mmi-sc/JISD5601Pulse/README.md

# JISD5601Pulse
JIS D 5601 Speed Pulse Generator
