mmi-sc/JISD5601Pulse/KiCad/CarSpeedPulser.pdf

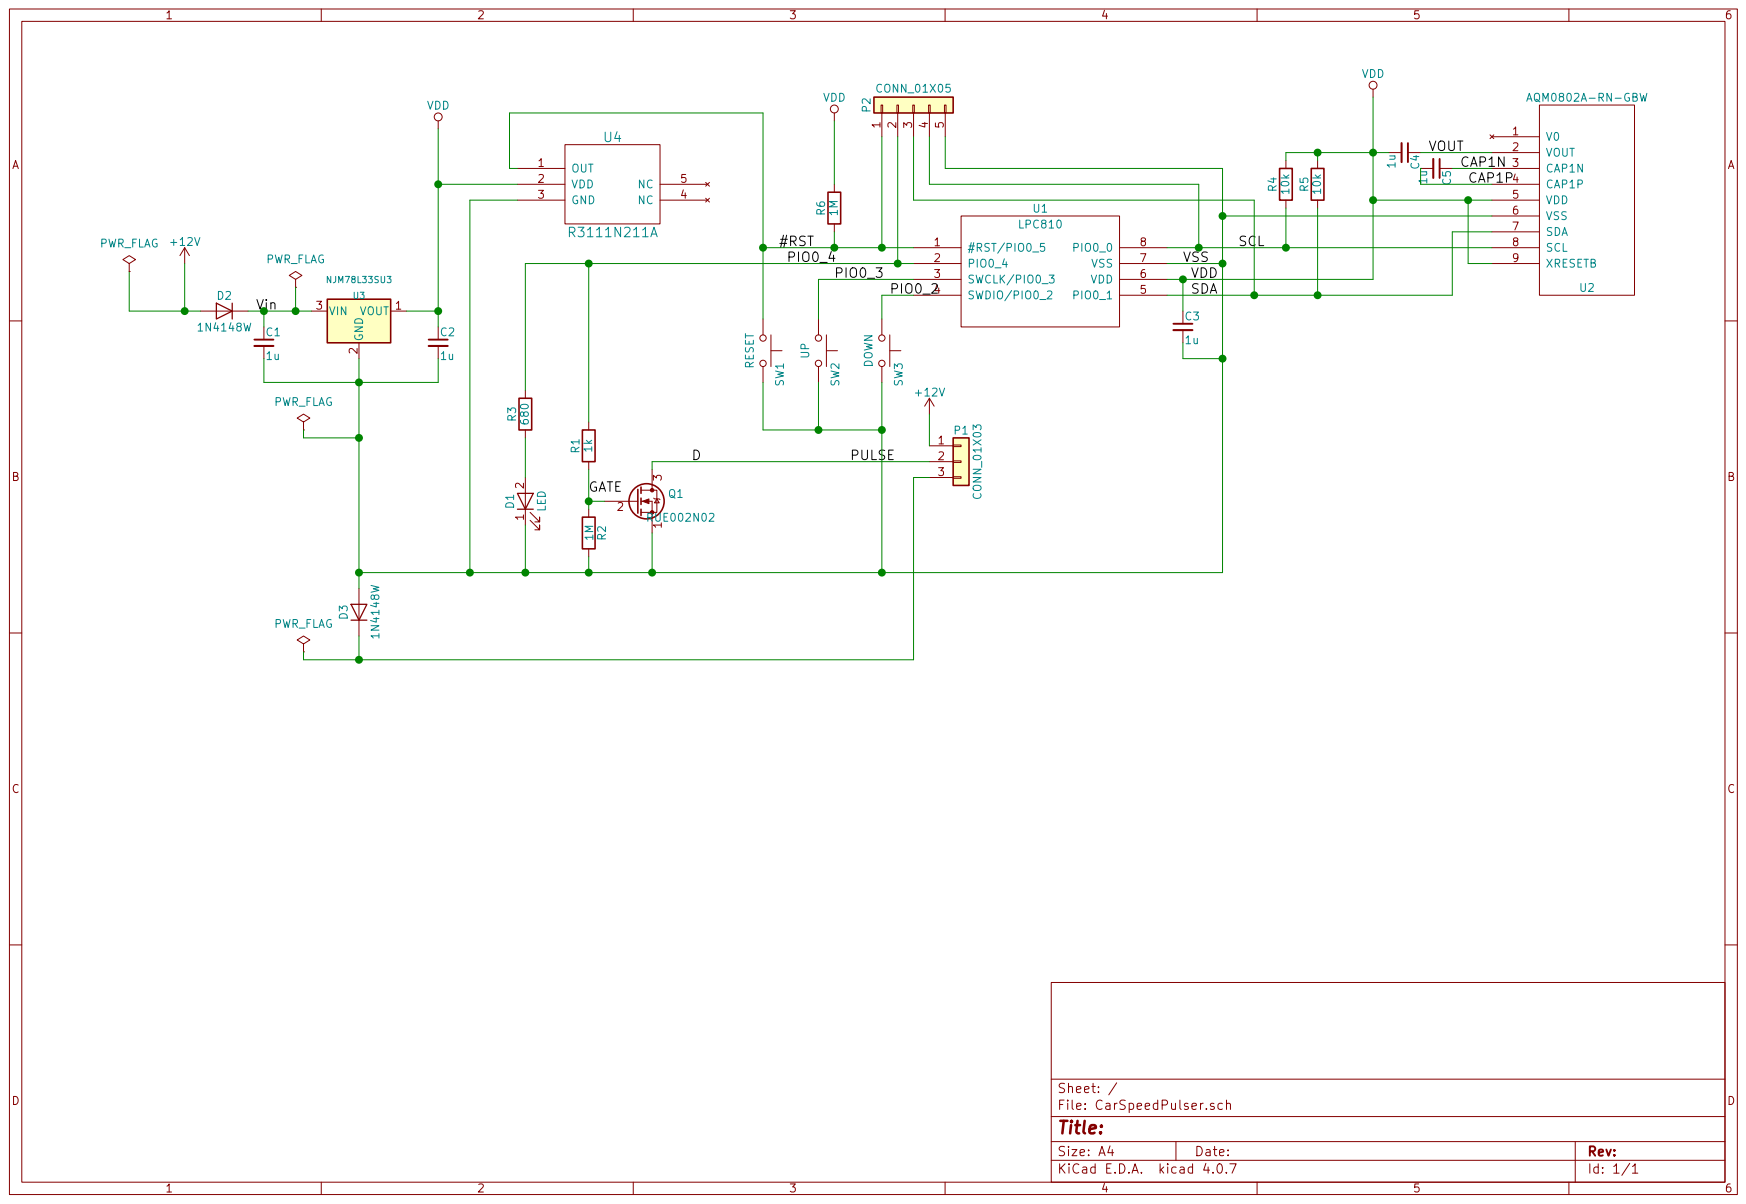
[picture p1: page 1]
