mmi-sc/JISD5601Pulse/KiCad/CarSpeedPulser.kicad_pcb

## KiCad design KiCad/CarSpeedPulser.kicad_pcb (2018-09-03)

Schematic: CarSpeedPulser.sch

Parts:
C1, C2, C3, C4, C5: 1u; C_0805_HandSoldering
D1: LED; LED_1206_3216Metric_Pad1.07x1.80mm_HandSolder
D2, D3: 1N4148W; SOD-123
P1: CONN_01X03; Socket_Strip_Angled_1x03
P2: CONN_01X05; Pin_Header_Straight_1x05
Q1: RUE002N02; EMT3
R1: 1k; R_0603_1608Metric_Pad0.84x1.00mm_HandSolder
R2: 1M; R_0603_1608Metric_Pad0.84x1.00mm_HandSolder
R3: 680; R_0603_1608Metric_Pad0.84x1.00mm_HandSolder
R4, R5: 10k; R_0603_1608Metric_Pad0.84x1.00mm_HandSolder
R6: 1M; R_0603_HandSoldering
SW1: RESET; Elko_vert_11.2x6.3mm_RM2.5
SW2: UP; Elko_vert_11.2x6.3mm_RM2.5
SW3: DOWN; Elko_vert_11.2x6.3mm_RM2.5
U1: LPC810; DIP-8_W7.62mm
U2: AQM0802A-RN-GBW
U3: NJM78L33SU3; SOT-89-3_Handsoldering
U4: R3111N211A; SOT-23-5_HandSoldering

Connections:
+12V: D2.2, P1.1
/#RST: P2.1, R6.1, SW1.1, U1.1, U4.1
/CAP1N: C5.1, U2.3
/CAP1P: C5.2, U2.4
/D: P1.2, Q1.3
/GATE: Q1.2, R1.1, R2.1
/PIO0_2: SW3.1, U1.4
/PIO0_3: SW2.1, U1.3
/PIO0_4: P2.2, R1.2, R3.2, U1.2
/SCL: P2.4, R4.1, U1.8, U2.8
/SDA: P2.3, R5.1, U1.5, U2.7
/VOUT: C4.1, U2.2
/VSS: C1.2, C2.2, C3.2, D1.1, D3.2, P2.5, Q1.1, R2.2, SW1.2, SW2.2, SW3.2, U1.7, U2.6, U3.2, U4.3
/Vin: C1.1, D2.1, U3.3
unnamed: D1.2, R3.1
unnamed: D3.1, P1.3
VDD: C2.1, C3.1, C4.2, R4.2, R5.2, R6.2, U1.6, U2.5, U2.9, U3.1, U4.2

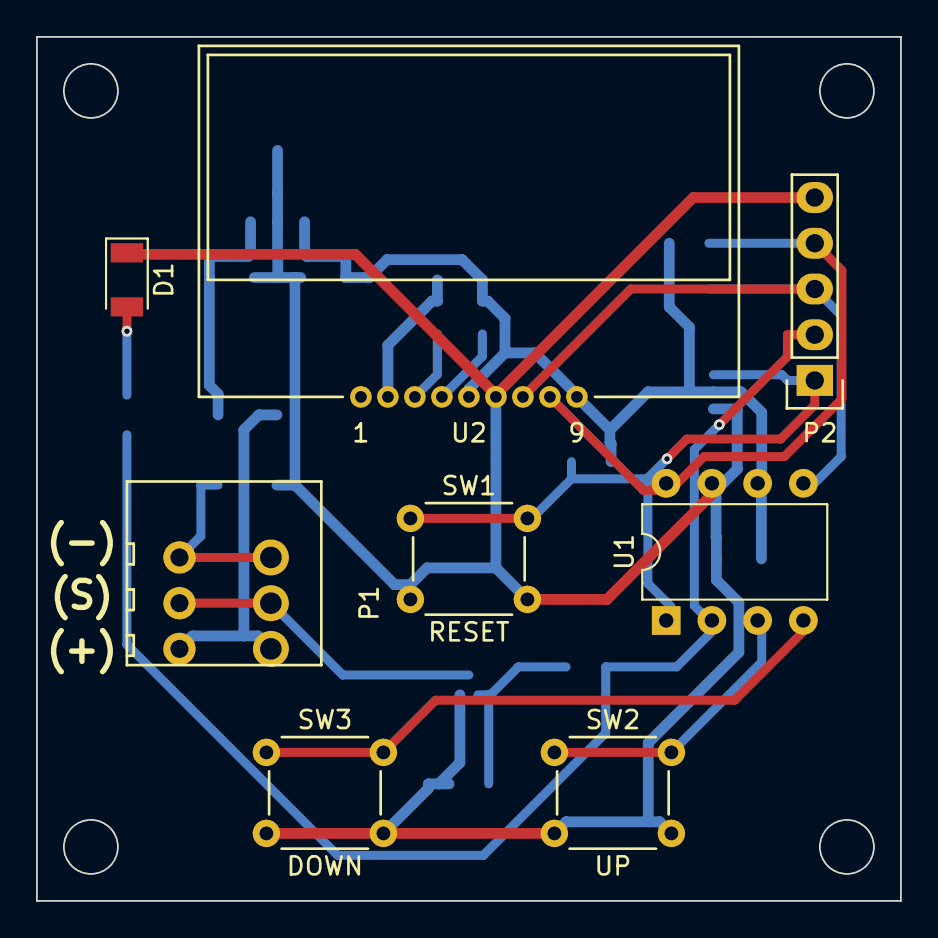
[picture p2: board CarSpeedPulser.kicad_pcb from above]

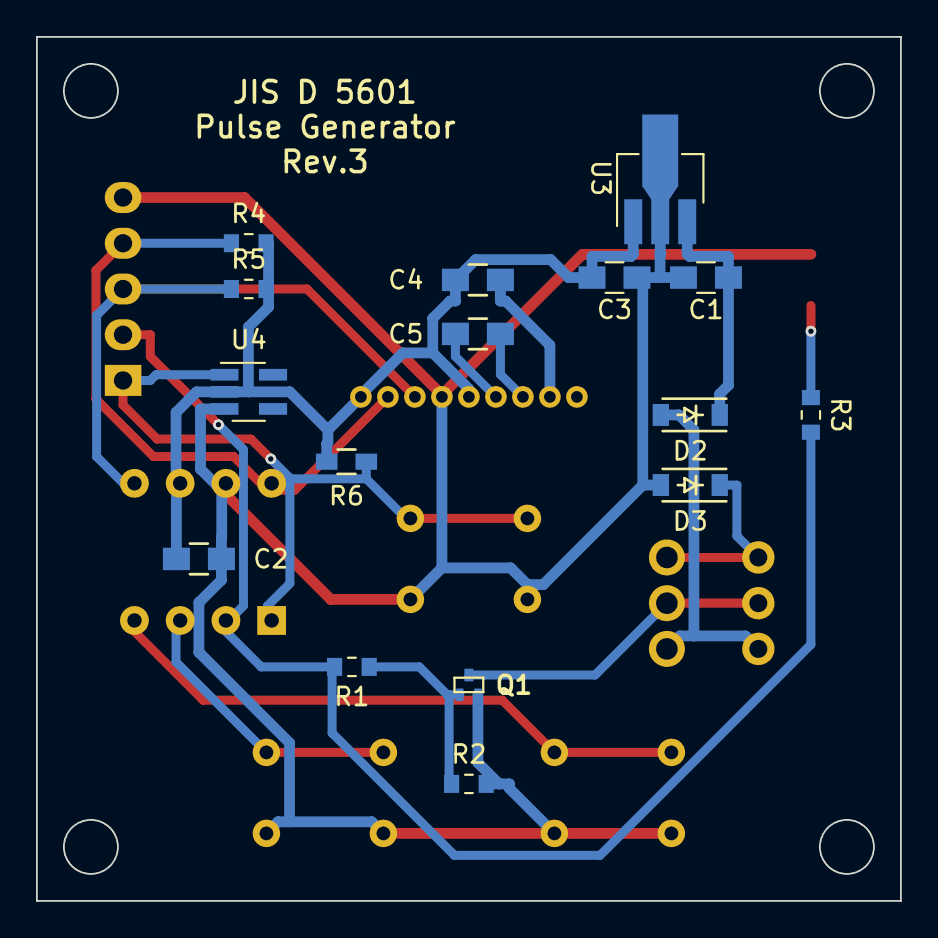
[picture p3: board CarSpeedPulser.kicad_pcb from below]

Board: 2 copper layers, 48.0 x 48.0 mm, 24 parts (16 on the bottom side), 17 nets.
