mmi-sc/JISD5601Pulse/src/iocon.c

/*
* @brief 
* This file is used to config IOCON module.
*
* @note
* Copyright(C) NXP Semiconductors, 2015
* All rights reserved.
*
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
* @par
* Permission to use, copy, modify, and distribute this software and its
* documentation is hereby granted, under NXP Semiconductors' and its
* licensor's relevant copyrights in the software, without fee, provided that it
* is used in conjunction with NXP Semiconductors microcontrollers.  This
* copyright, permission, and disclaimer notice must appear in all copies of
* this code.
*/
    
#include "LPC8xx.h"    /* LPC8xx Peripheral Registers */
#include "type.h"

void IOCON_Init() {
    
    /* Enable UART clock */
    LPC_SYSCON->SYSAHBCLKCTRL |= (1<<18);

    /* Pin I/O Configuration */
    /* LPC_IOCON->PIO0_0 = 0x90; */
    /* LPC_IOCON->PIO0_1 = 0x90; */
    /* LPC_IOCON->PIO0_2 = 0x90; */
    /* LPC_IOCON->PIO0_3 = 0x90; */
    /* LPC_IOCON->PIO0_4 = 0x90; */
    /* LPC_IOCON->PIO0_5 = 0x90; */
}
 /**********************************************************************
 **                            End Of File
 **********************************************************************/
