mmi-sc/JISD5601Pulse/(commit log)

2015-05-17 Blink a LED slowly by SCT.
2015-05-17 ボタンによる指令が不調。
2015-05-17 It's buggy. Strange behavior.
    [main.c]
2015-05-18 Added KiCad PCB data.
    [CarSpeedPulser.kicad_pcb, CarSpeedPulser.sch]
2015-05-18 Initialize I2C LCD before GPIO.
2015-05-18 Added writer connector.
    [CarSpeedPulser.kicad_pcb, CarSpeedPulser.sch]
2015-05-18 Added Switch Matrix Tool output.
2015-05-19 Updated circuit diagram.
    [CarSpeedPulser.kicad_pcb, CarSpeedPulser.sch]
2015-05-19 Convert to ihex.
    [CarSpeedPulser.sch]
2015-05-21 Correct values of capacitors.
    [CarSpeedPulser.sch]
2015-05-22 Replaced a connector.
    [CarSpeedPulser.kicad_pcb, CarSpeedPulser.sch]
2015-11-05 Removed pullup register. PULSE output is open drain.
    [CarSpeedPulser.kicad_pcb, CarSpeedPulser.sch]
2015-11-09 Replaced AE-AQM802 with AQM0802A-RN-GBW.
    [CarSpeedPulser.kicad_pcb, CarSpeedPulser.sch]
2015-11-09 Changed footprint of a speaker.
    [CarSpeedPulser.sch]
2015-11-10 Added a footprint of terminal block.
    [CarSpeedPulser.kicad_pcb]
2015-11-10 Replaced footprint of AQM0802A-RN-GBW.
    [CarSpeedPulser.kicad_pcb]
2015-11-10 Added footprint of piezo speaker.
    [CarSpeedPulser.kicad_pcb]
2015-11-15 Replaced voltage regulator to SMD type.
    [CarSpeedPulser.kicad_pcb, CarSpeedPulser.sch]
2016-01-25 Added diodes, registers and a voltage detector.
    [CarSpeedPulser.kicad_pcb, CarSpeedPulser.sch]
2016-04-06 Changed directory name of 3D shapes.
    [CarSpeedPulser.kicad_pcb]
2017-09-26 Updated KiCad parts library
    [CarSpeedPulser.kicad_pcb, CarSpeedPulser.sch]
2017-09-26 Replaced 3.3V regulator
    [CarSpeedPulser.kicad_pcb, CarSpeedPulser.sch]
2017-10-03 Replaced voltage detector
    [CarSpeedPulser.kicad_pcb, CarSpeedPulser.sch]
2017-10-07 Replaced 3D models path
    Replaced 3D models path.
    Removed unused footprints.
    [CarSpeedPulser.kicad_pcb]
2018-09-03 Migrated to KiCad 5.0
    [CarSpeedPulser.kicad_pcb, CarSpeedPulser.sch]
